GeraldWodni/bitkanoneV2/eda/doc/pcb_back.png

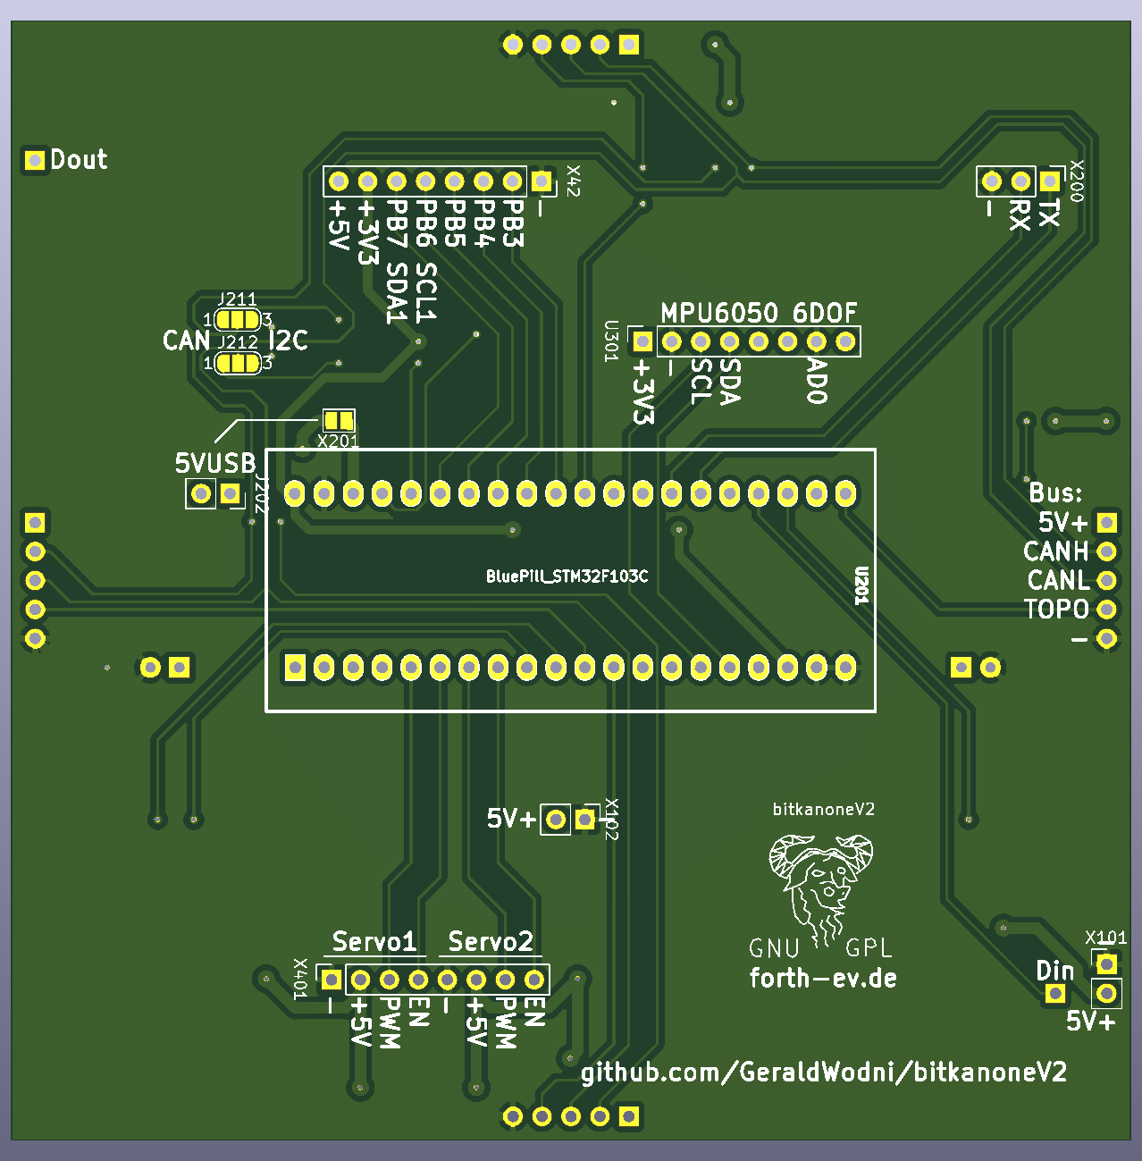
eda/doc/pcb_back.png
