GeraldWodni/bitkanoneV2/eda/doc/pcb_front.png

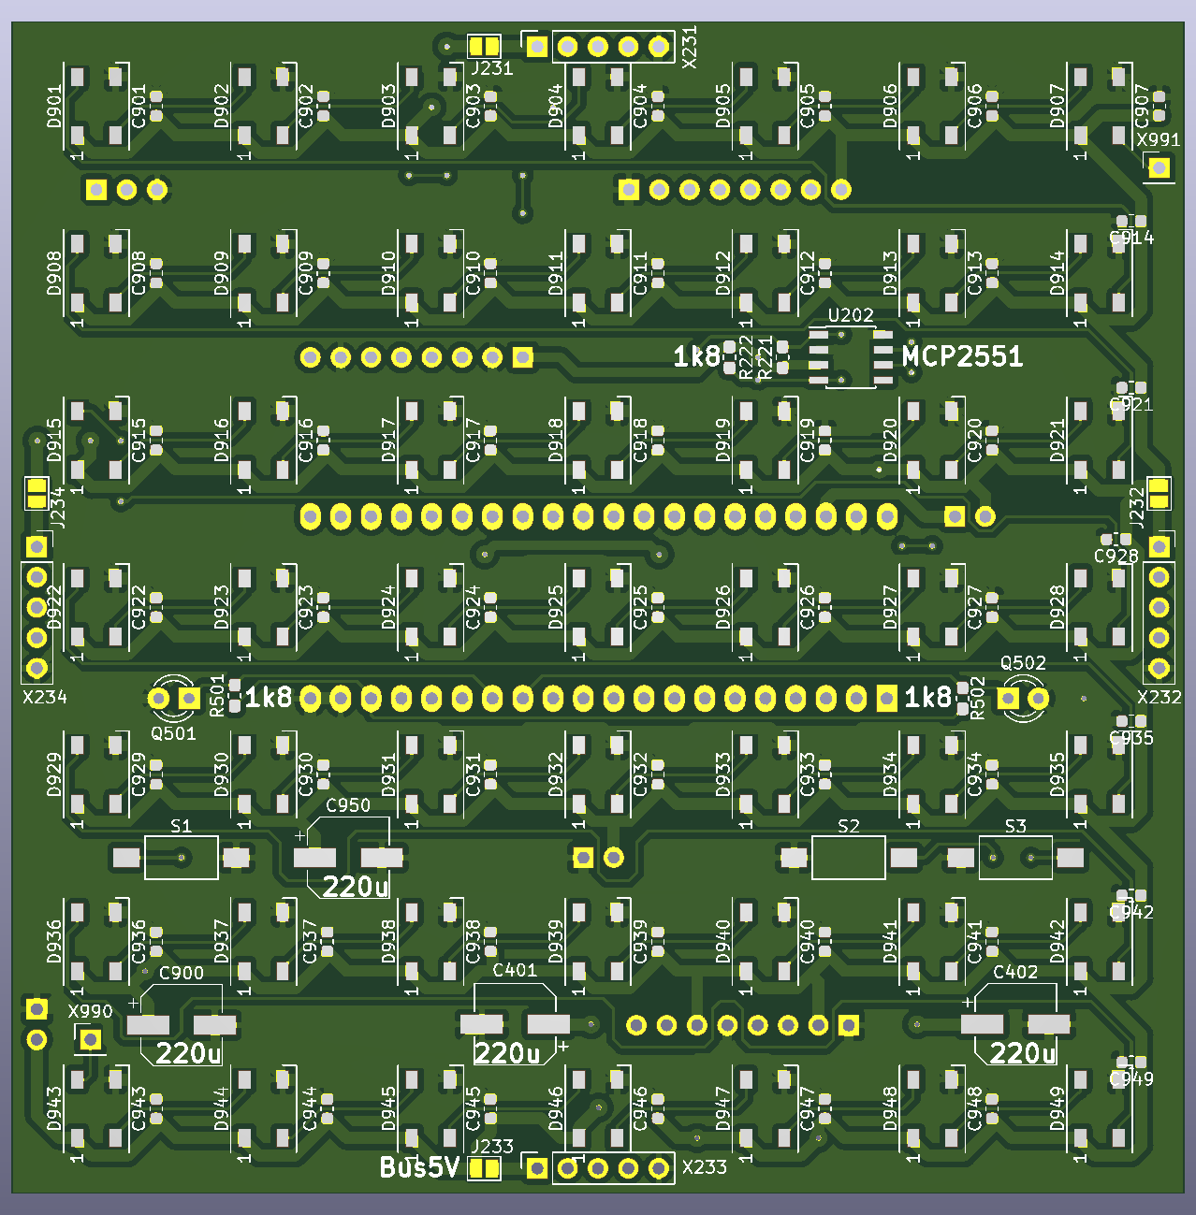
eda/doc/pcb_front.png
