GeraldWodni/bitkanoneV2/cad/Handheld.stl

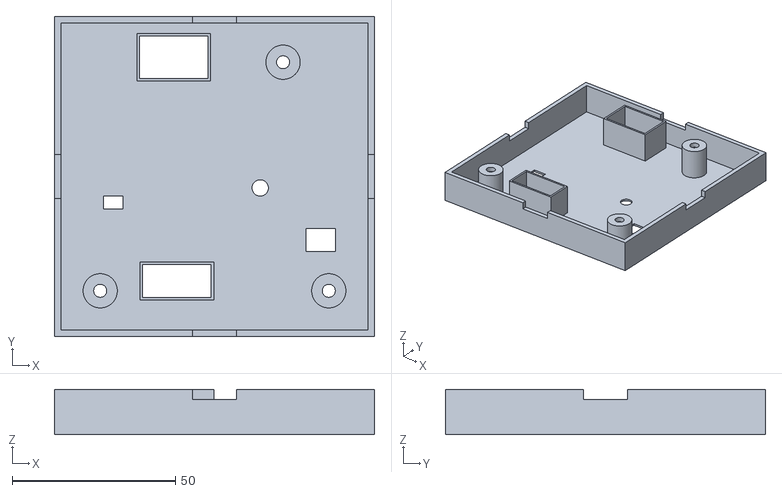
[picture p3: CAD file, 2019-04-07]
cad/Handheld.stl
98.0 x 98.0 x 13.8
