GeraldWodni/bitkanoneV2/cad/ResetButton.stl

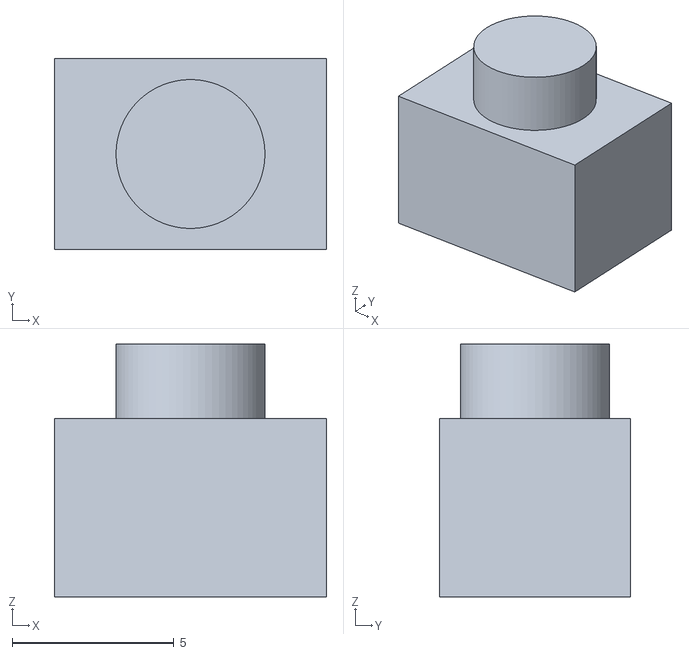
[picture p4: CAD file, 2019-04-07]
cad/ResetButton.stl
8.40 x 5.90 x 7.80
