GeraldWodni/bitkanoneV2/cad/Button.stl

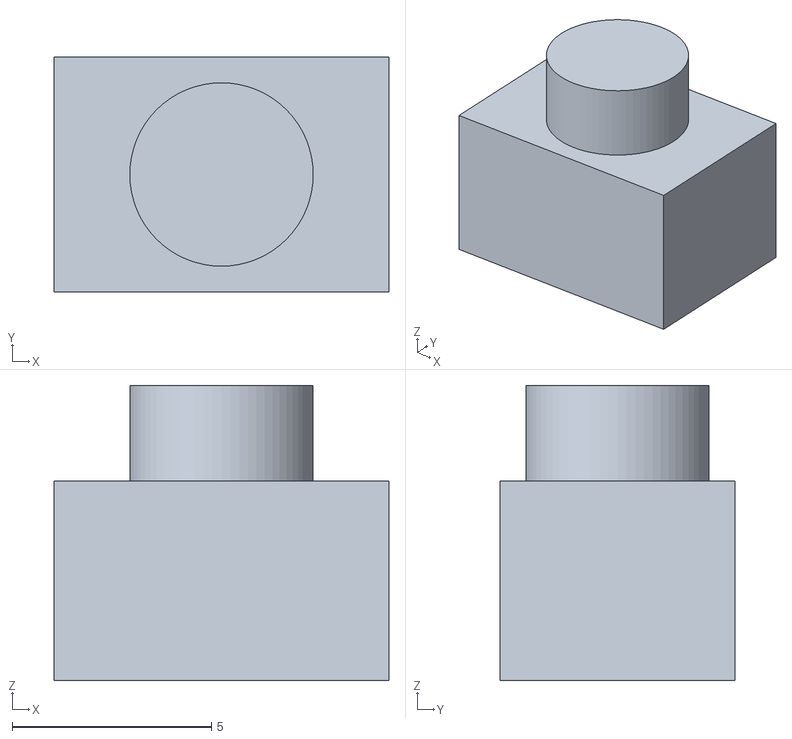
[picture p5: CAD file, 2019-04-07]
cad/Button.stl
8.40 x 5.90 x 7.40
