GeraldWodni/bitkanoneV2/cad/PanTiltMiddle.stl

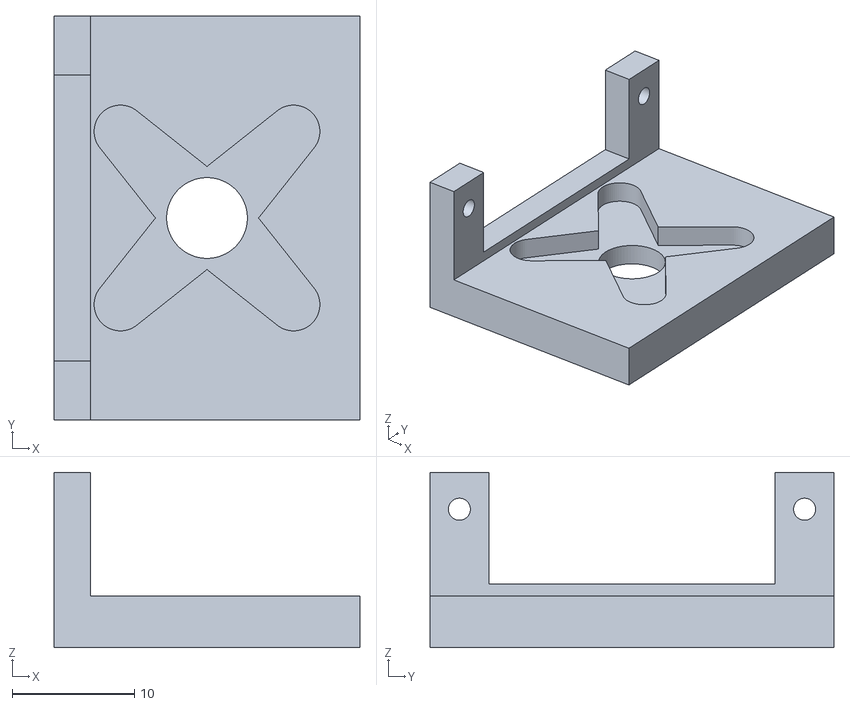
[picture p6: CAD file, 2018-12-27]
cad/PanTiltMiddle.stl
25.0 x 33.0 x 14.3
