GeraldWodni/bitkanoneV2/cad/PanTiltTop.stl

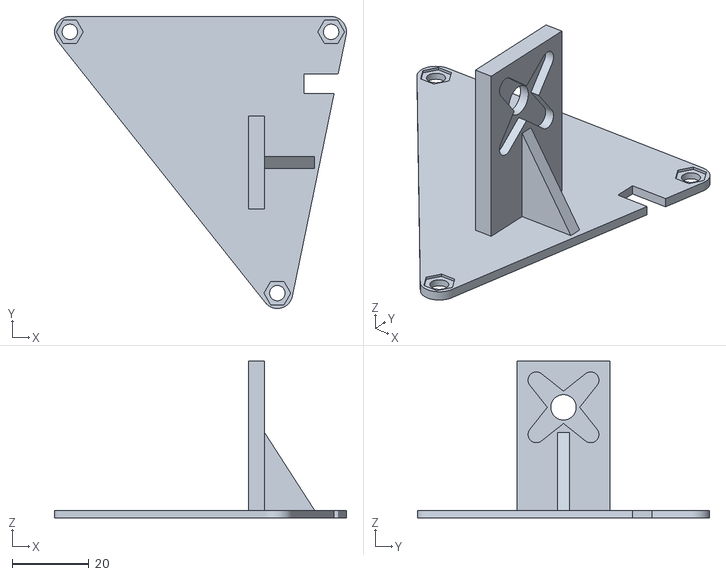
[picture p7: CAD file, 2018-12-27]
cad/PanTiltTop.stl
76.0 x 76.0 x 40.9
