GeraldWodni/bitkanoneV2/cad/PanTiltBottom.stl

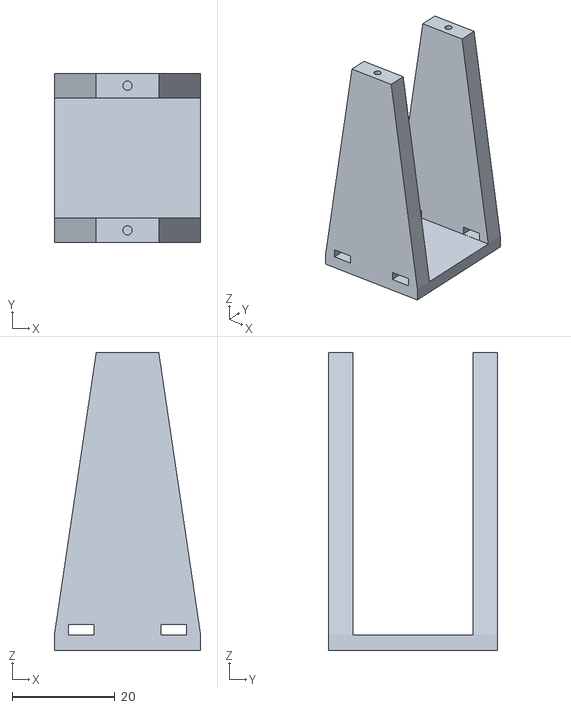
[picture p8: CAD file, 2018-12-27]
cad/PanTiltBottom.stl
28.5 x 33.0 x 58.1
