GeraldWodni/bitkanoneV2/cad/PanTiltSpacer.stl

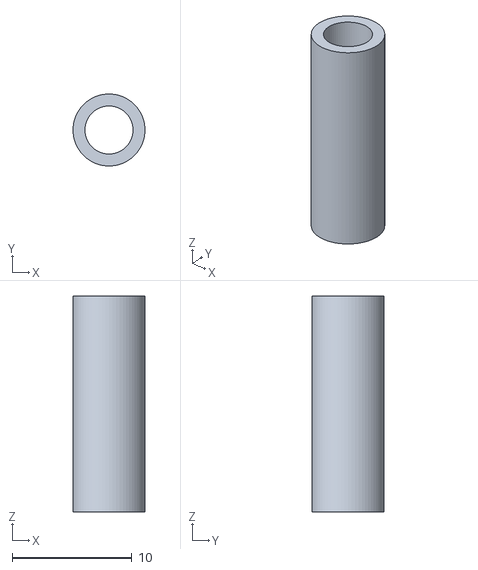
[picture p9: CAD file, 2018-12-27]
cad/PanTiltSpacer.stl
6.00 x 6.00 x 18.0
