GeraldWodni/bitkanoneV2/(threads)

Thread 3 (2019-01-03):

fonts does not work without USB driver

helmwo, 2019-01-03:
If you setup bitkanone without USB driver, it fails with fonts/fonts.fs.
C, is missing, this is defined inside standard.fs and usb-f1.txt.

So inside e4thcom.fs it's better to put the include for fonts/fonts.fs behind standard.fs.
The redefinition of C, should also be avoided. Maybe making standard.fs needed part for all sources.
