GeraldWodni/bitkanoneV2/eda/doc/BitkanoneV2-schematic.pdf

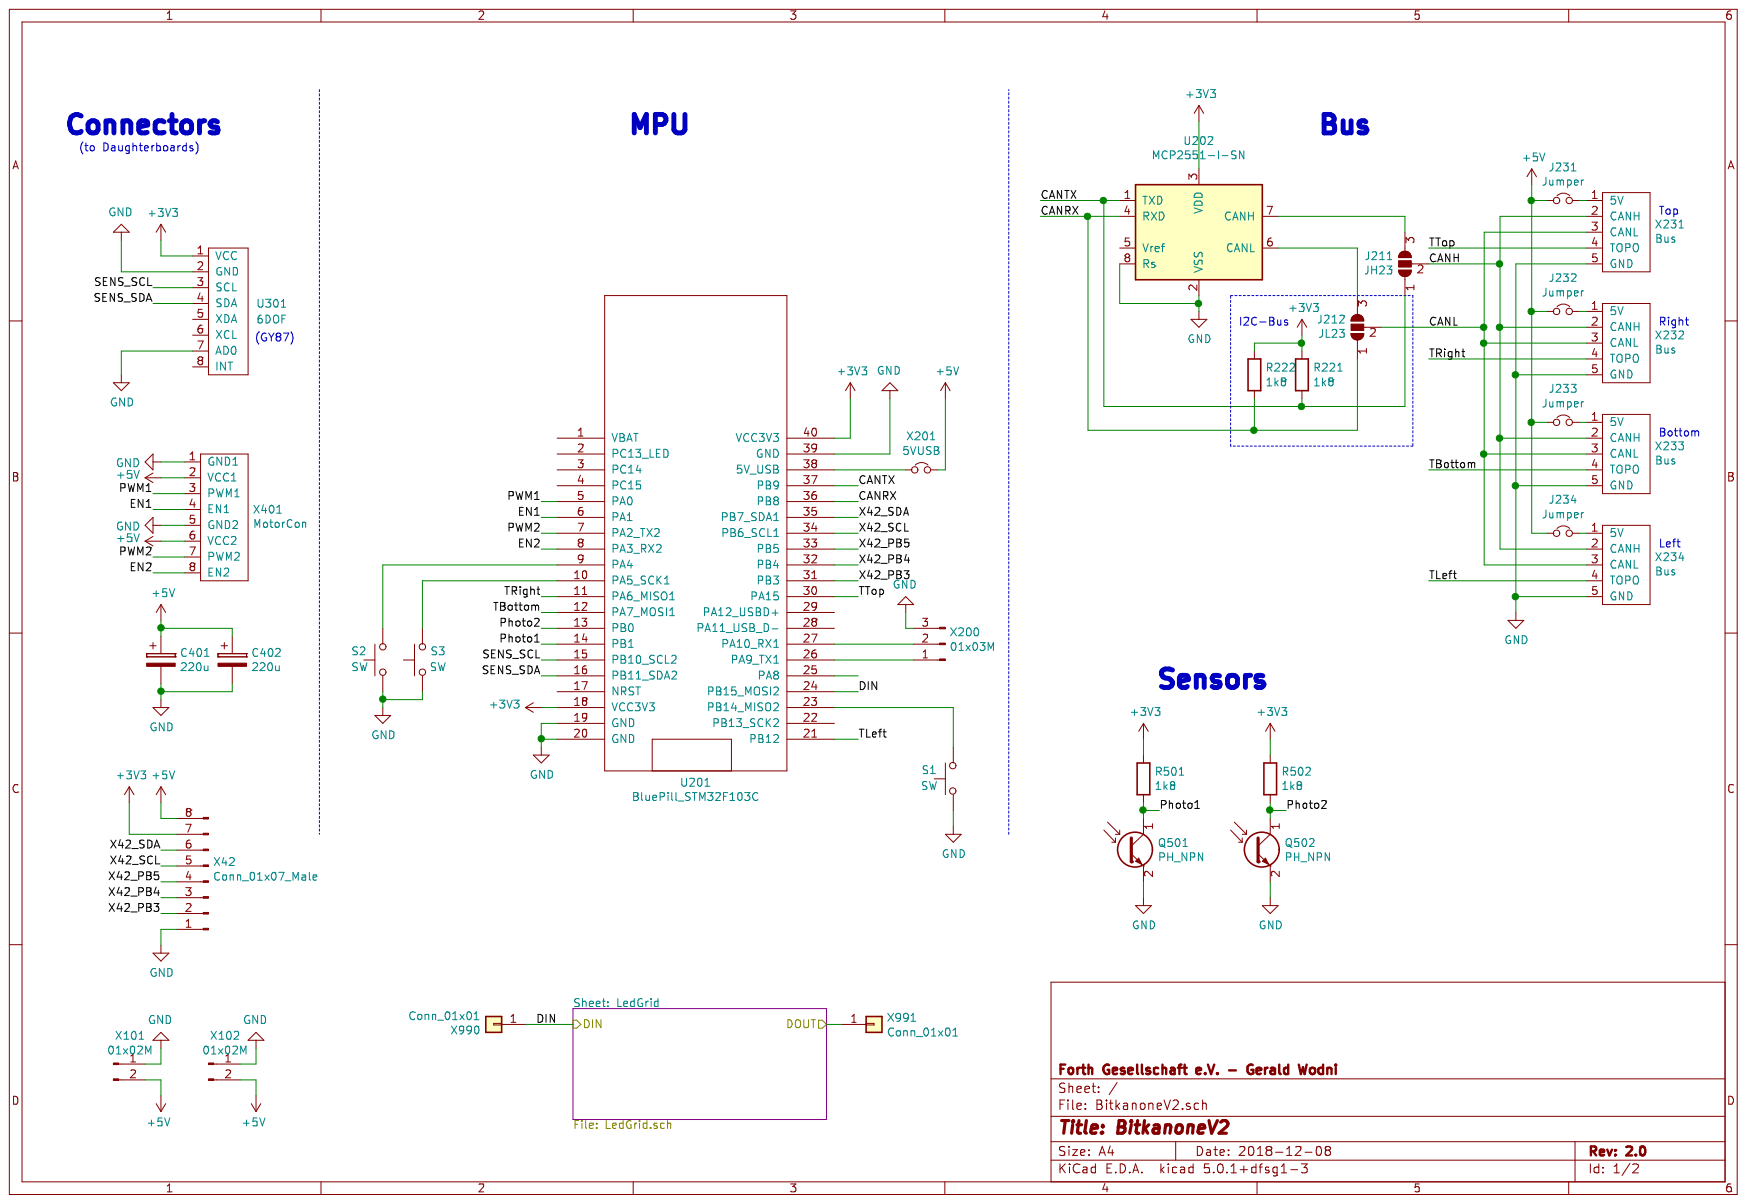
[picture p10: page 1]

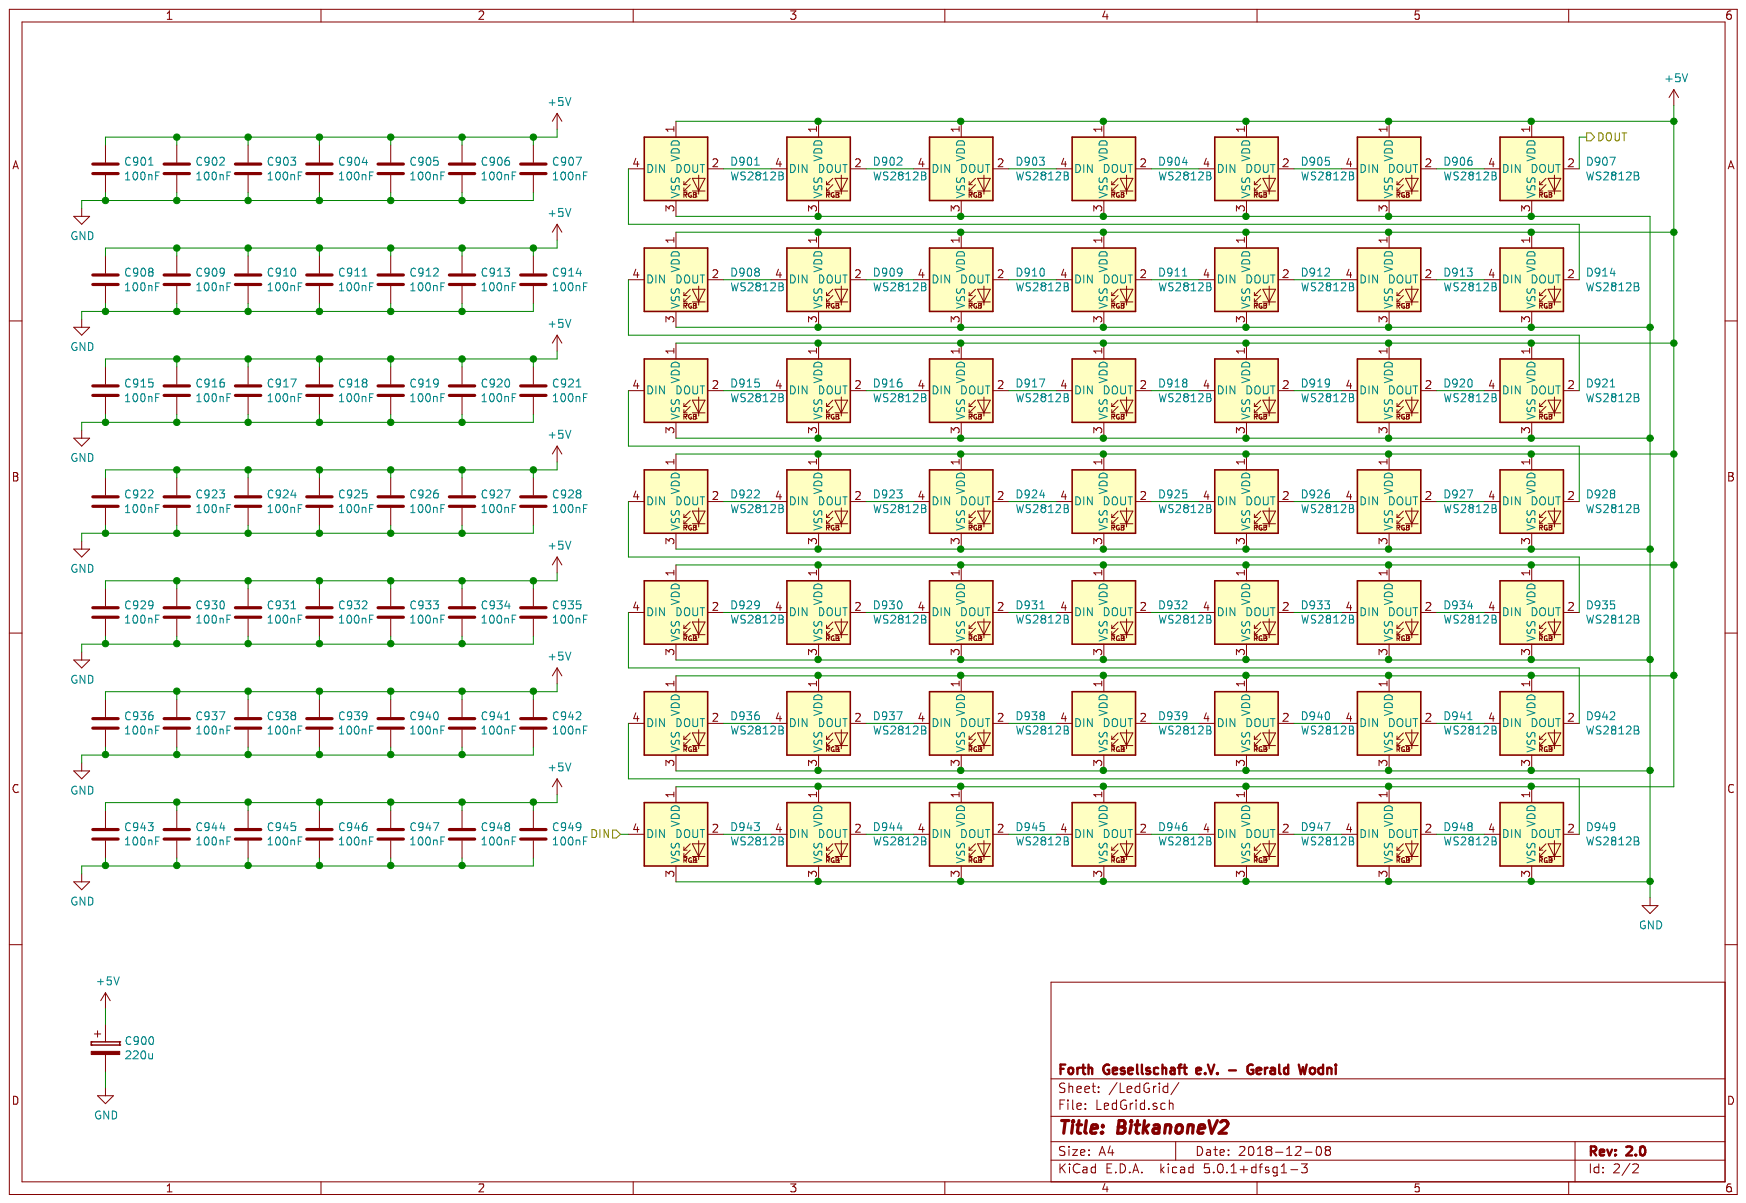
[picture p11: page 2]
