GeraldWodni/bitkanoneV2/eda/doc/BitkanoneV2-pcb.pdf

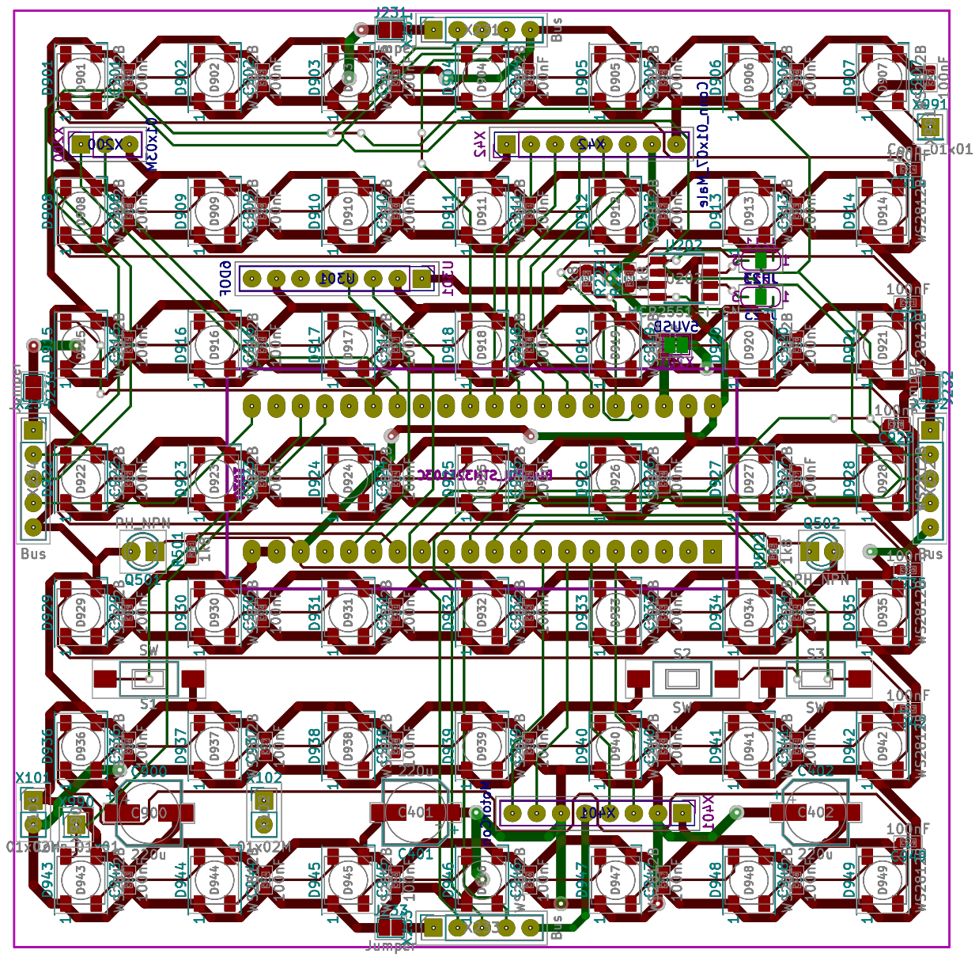
[picture p12: page 1]
