GeraldWodni/bitkanoneV2/eda/BitkanoneV2.kicad_pcb

## KiCad design eda/BitkanoneV2.kicad_pcb (2018-12-12)

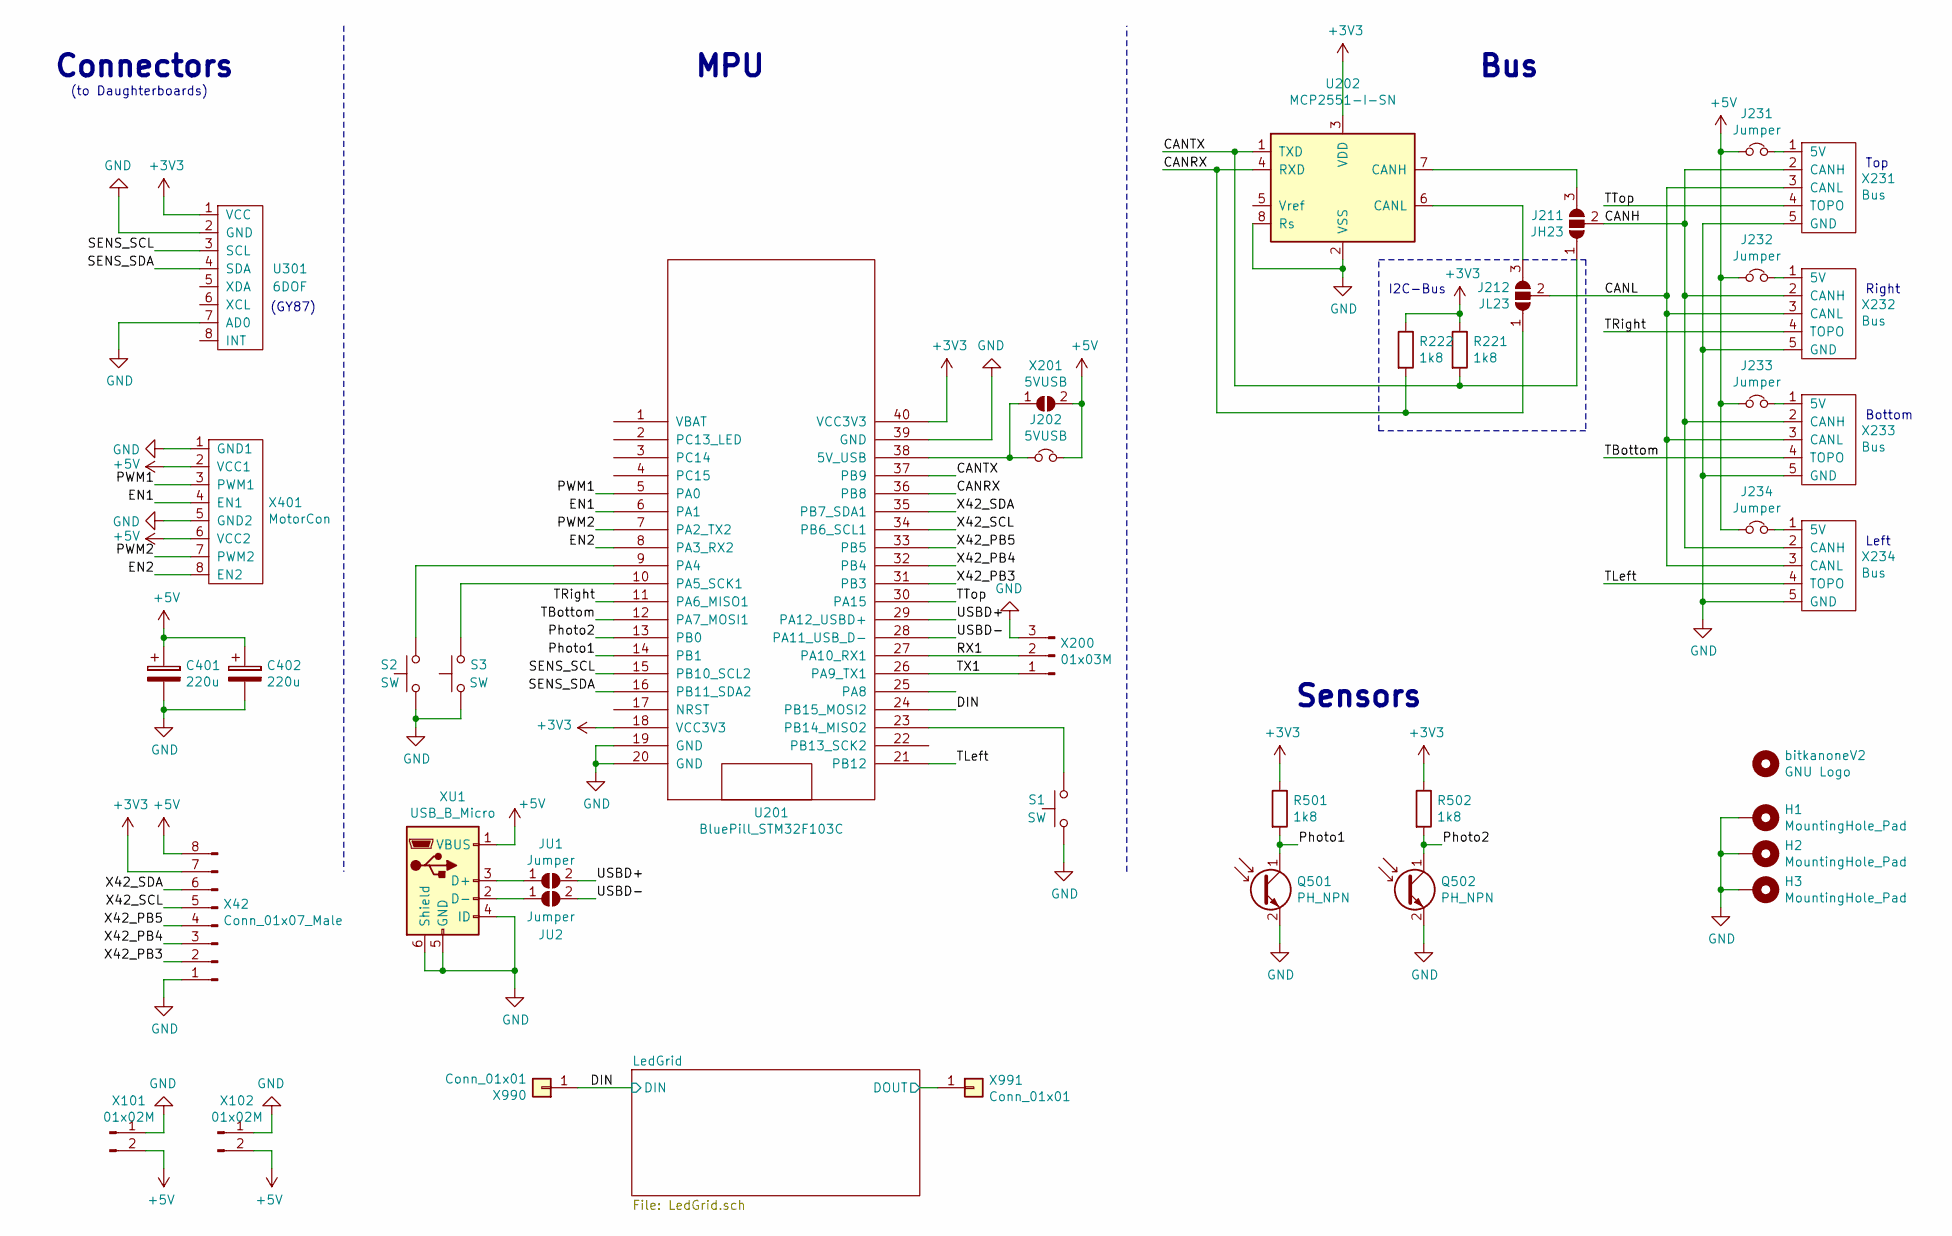
[picture p13: schematic BitkanoneV2.sch]

Parts:
C401, C402: 220u; CP_Elec_6.3x5.3
H1, H2, H3: MountingHole_Pad; MountingHole_3.2mm_M3_Pad_Via
J202: 5VUSB; PinSocket_1x02_P2.54mm_Vertical
J211: JH23; SolderJumper-3_P1.3mm_Open_RoundedPad1.0x1.5mm_NumberLabels
J212: JL23; SolderJumper-3_P1.3mm_Open_RoundedPad1.0x1.5mm_NumberLabels
J231, J232, J233, J234: Jumper; SolderJumper-2_P1.3mm_Open_Pad1.0x1.5mm
JU1, JU2: Jumper; SolderJumper-2_P1.3mm_Open_RoundedPad1.0x1.5mm
Q501, Q502: PH_NPN; LED_D3.0mm
R221, R222, R501, R502: 1k8; R_0603_1608Metric_Pad1.05x0.95mm_HandSolder
S1, S2, S3: SW; SW_SPST_FSMSM
U201: BluePill_STM32F103C; BluePill_STM32F103C_Center_NoPROG
U202: MCP2551-I-SN; SOIC-8_3.9x4.9mm_P1.27mm
U301: 6DOF; PinSocket_1x08_P2.54mm_Vertical
X42: Conn_01x07_Male; PinSocket_1x08_P2.54mm_Vertical
X101, X102: 01x02M; PinHeader_1x02_P2.54mm_Vertical
X200: 01x03M; PinHeader_1x03_P2.54mm_Vertical
X201: 5VUSB; SolderJumper-2_P1.3mm_Open_Pad1.0x1.5mm
X231, X232, X233, X234: Bus; PinSocket_1x05_P2.54mm_Vertical
X401: MotorCon; PinSocket_1x08_P2.54mm_Vertical
X990, X991: Conn_01x01; PinHeader_1x01_P2.54mm_Vertical
XU1: USB_B_Micro; USB_Micro-B_Molex-105017-0001
bitkanoneV2: GNU Logo; Symbol_GNU-Logo_SilkscreenTop

Connections:
+3V3: R221.1, R222.1, R501.1, R502.1, U201.18 (VCC3V3), U201.40 (VCC3V3), U202.3 (VDD), U301.1 (VCC), X42.7
+5V: C401.1, C402.1, J202.2, J231.1, J232.1, J233.1, J234.1, X42.8, X101.2, X102.2, X201.2 (B), X401.2 (VCC1), X401.6 (VCC2), XU1.1 (VBUS); also elsewhere on the board
/CANH: J211.2 (C), X231.2 (CANH), X232.2 (CANH), X233.2 (CANH), X234.2 (CANH)
/CANL: J212.2 (C), X231.3 (CANL), X232.3 (CANL), X233.3 (CANL), X234.3 (CANL)
/CANRX: J212.1 (A), R222.2, U201.36 (PB8), U202.4 (RXD)
/CANTX: J211.1 (A), R221.2, U201.37 (PB9), U202.1 (TXD)
/DIN: U201.24 (PB15_MOSI2), X990.1; also elsewhere on the board
/EN1: U201.6 (PA1), X401.4 (EN1)
/EN2: U201.8 (PA3_RX2), X401.8 (EN2)
/LedGrid/DOUT: X991.1; also elsewhere on the board
/PWM1: U201.5 (PA0), X401.3 (PWM1)
/PWM2: U201.7 (PA2_TX2), X401.7 (PWM2)
/Photo1: Q501.1 (C), R501.2, U201.14 (PB1)
/Photo2: Q502.1 (C), R502.2, U201.13 (PB0)
/RX1: U201.27 (PA10_RX1), X200.2
/SENS_SCL: U201.15 (PB10_SCL2), U301.3 (SCL)
/SENS_SDA: U201.16 (PB11_SDA2), U301.4 (SDA)
/TBottom: U201.12 (PA7_MOSI1), X233.4 (TOPO)
/TLeft: U201.21 (PB12), X234.4 (TOPO)
/TRight: U201.11 (PA6_MISO1), X232.4 (TOPO)
/TTop: U201.30 (PA15), X231.4 (TOPO)
/TX1: U201.26 (PA9_TX1), X200.1
/USBD+: JU1.2 (B), U201.29 (PA12_USBD+)
/USBD-: JU2.2 (B), U201.28 (PA11_USB_D-)
/X42_PB3: U201.31 (PB3), X42.2
/X42_PB4: U201.32 (PB4), X42.3
/X42_PB5: U201.33 (PB5), X42.4
/X42_SCL: U201.34 (PB6_SCL1), X42.5
/X42_SDA: U201.35 (PB7_SDA1), X42.6
GND: C401.2, C402.2, H1.1, H2.1, H3.1, Q501.2 (E), Q502.2 (E), S1.1, S2.1, S3.1, U201.19 (GND), U201.20 (GND), U201.39 (GND), U202.2 (VSS), U202.8 (Rs), U301.2 (GND), U301.7 (AD0), X42.1, X101.1, X102.1, X200.3, X231.5 (GND), X232.5 (GND), X233.5 (GND), X234.5 (GND), X401.1 (GND1), X401.5 (GND2), XU1.4 (ID), XU1.5 (GND), XU1.6 (Shield); also elsewhere on the board
unnamed: J202.1, U201.38 (5V_USB), X201.1 (A)
unnamed: J211.3 (B), U202.7 (CANH)
unnamed: J212.3 (B), U202.6 (CANL)
unnamed: J231.2, X231.1 (5V)
unnamed: J232.2, X232.1 (5V)
unnamed: J233.2, X233.1 (5V)
unnamed: J234.2, X234.1 (5V)
unnamed: JU1.1 (A), XU1.3 (D+)
unnamed: JU2.1 (A), XU1.2 (D-)
unnamed: S1.2, U201.23 (PB14_MISO2)
unnamed: S2.2, U201.9 (PA4)
unnamed: S3.2, U201.10 (PA5_SCK1)

Notes on the sheet:
I2C-Bus
Bus
MPU
Connectors
(to Daughterboards)
(GY87)
Left
Bottom
Right
Top
Sensors

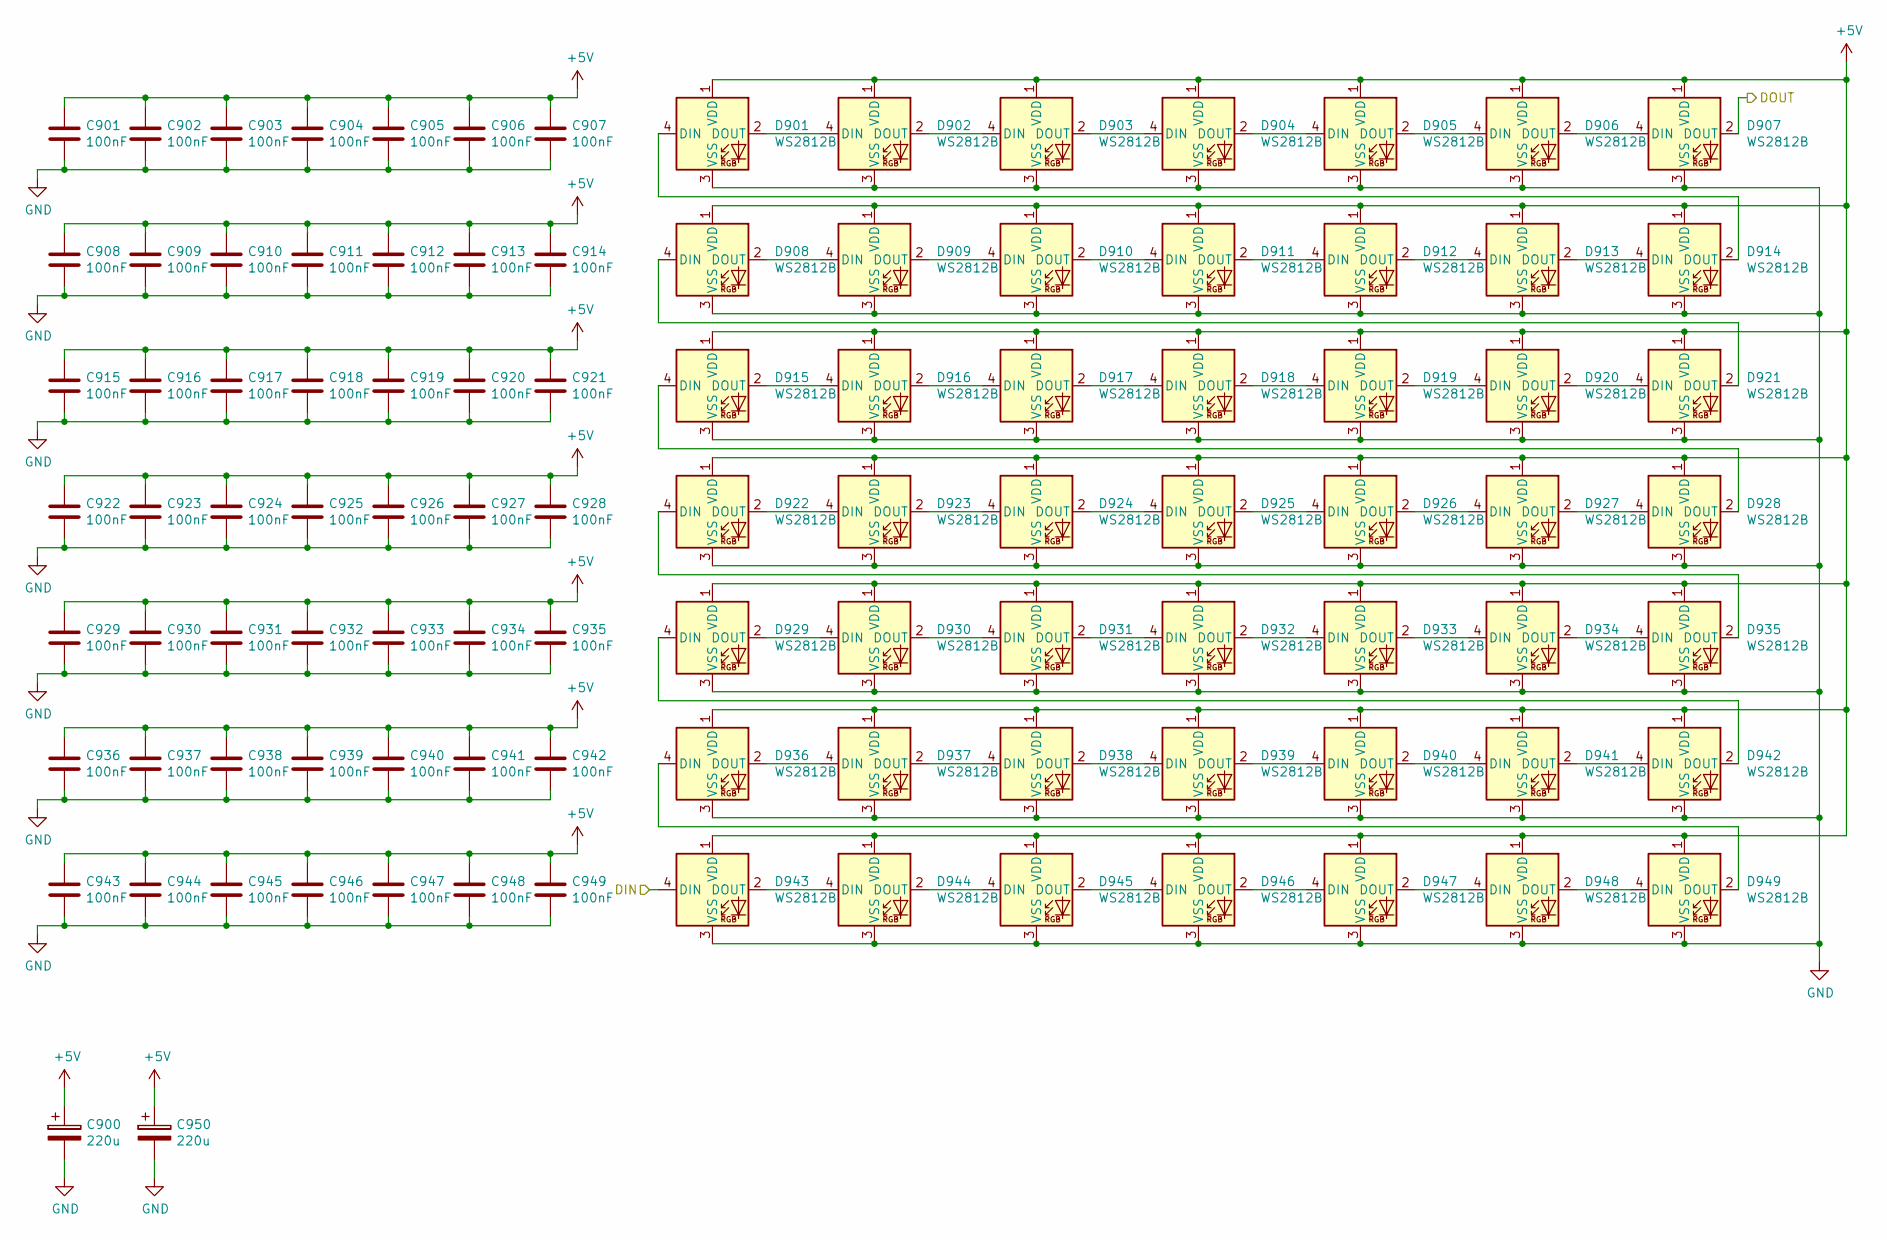
[picture p14: schematic LedGrid.sch, BitkanoneV2]

Parts:
C900, C950: 220u; CP_Elec_6.3x5.3
C901, C902, C903, C904, C905, C906, C907, C908, C909, C910, C911, C912, C913, C914, C915, C916, C917, C918, C919, C920, C921, C922, C923, C924, C925, C926, C927, C928, C929, C930, C931, C932, C933, C934, C935, C936, C937, C938, C939, C940, C941, C942, C943, C944, C945, C946, C947, C948, C949: 100nF; C_0603_1608Metric
D901, D902, D903, D904, D905, D906, D907, D908, D909, D910, D911, D912, D913, D914, D915, D916, D917, D918, D919, D920, D921, D922, D923, D924, D925, D926, D927, D928, D929, D930, D931, D932, D933, D934, D935, D936, D937, D938, D939, D940, D941, D942, D943, D944, D945, D946, D947, D948, D949: WS2812B; LED_WS2812B_PLCC4_5.0x5.0mm_P3.2mm

Connections:
+5V: C900.1, C901.1, C902.1, C903.1, C904.1, C905.1, C906.1, C907.1, C908.1, C909.1, C910.1, C911.1, C912.1, C913.1, C914.1, C915.1, C916.1, C917.1, C918.1, C919.1, C920.1, C921.1, C922.1, C923.1, C924.1, C925.1, C926.1, C927.1, C928.1, C929.1, C930.1, C931.1, C932.1, C933.1, C934.1, C935.1, C936.1, C937.1, C938.1, C939.1, C940.1, C941.1, C942.1, C943.1, C944.1, C945.1, C946.1, C947.1, C948.1, C949.1, C950.1, D901.1 (VDD), D902.1 (VDD), D903.1 (VDD), D904.1 (VDD), D905.1 (VDD), D906.1 (VDD), D907.1 (VDD), D908.1 (VDD), D909.1 (VDD), D910.1 (VDD), D911.1 (VDD), D912.1 (VDD), D913.1 (VDD), D914.1 (VDD), D915.1 (VDD), D916.1 (VDD), D917.1 (VDD), D918.1 (VDD), D919.1 (VDD), D920.1 (VDD), D921.1 (VDD), D922.1 (VDD), D923.1 (VDD), D924.1 (VDD), D925.1 (VDD), D926.1 (VDD), D927.1 (VDD), D928.1 (VDD), D929.1 (VDD), D930.1 (VDD), D931.1 (VDD), D932.1 (VDD), D933.1 (VDD), D934.1 (VDD), D935.1 (VDD), D936.1 (VDD), D937.1 (VDD), D938.1 (VDD), D939.1 (VDD), D940.1 (VDD), D941.1 (VDD), D942.1 (VDD), D943.1 (VDD), D944.1 (VDD), D945.1 (VDD), D946.1 (VDD), D947.1 (VDD), D948.1 (VDD), D949.1 (VDD); also elsewhere on the board
/DIN: D943.4 (DIN); also elsewhere on the board
/LedGrid/DOUT: D907.2 (DOUT); also elsewhere on the board
GND: C900.2, C901.2, C902.2, C903.2, C904.2, C905.2, C906.2, C907.2, C908.2, C909.2, C910.2, C911.2, C912.2, C913.2, C914.2, C915.2, C916.2, C917.2, C918.2, C919.2, C920.2, C921.2, C922.2, C923.2, C924.2, C925.2, C926.2, C927.2, C928.2, C929.2, C930.2, C931.2, C932.2, C933.2, C934.2, C935.2, C936.2, C937.2, C938.2, C939.2, C940.2, C941.2, C942.2, C943.2, C944.2, C945.2, C946.2, C947.2, C948.2, C949.2, C950.2, D901.3 (VSS), D902.3 (VSS), D903.3 (VSS), D904.3 (VSS), D905.3 (VSS), D906.3 (VSS), D907.3 (VSS), D908.3 (VSS), D909.3 (VSS), D910.3 (VSS), D911.3 (VSS), D912.3 (VSS), D913.3 (VSS), D914.3 (VSS), D915.3 (VSS), D916.3 (VSS), D917.3 (VSS), D918.3 (VSS), D919.3 (VSS), D920.3 (VSS), D921.3 (VSS), D922.3 (VSS), D923.3 (VSS), D924.3 (VSS), D925.3 (VSS), D926.3 (VSS), D927.3 (VSS), D928.3 (VSS), D929.3 (VSS), D930.3 (VSS), D931.3 (VSS), D932.3 (VSS), D933.3 (VSS), D934.3 (VSS), D935.3 (VSS), D936.3 (VSS), D937.3 (VSS), D938.3 (VSS), D939.3 (VSS), D940.3 (VSS), D941.3 (VSS), D942.3 (VSS), D943.3 (VSS), D944.3 (VSS), D945.3 (VSS), D946.3 (VSS), D947.3 (VSS), D948.3 (VSS), D949.3 (VSS); also elsewhere on the board
unnamed: D901.2 (DOUT), D902.4 (DIN)
unnamed: D901.4 (DIN), D914.2 (DOUT)
unnamed: D902.2 (DOUT), D903.4 (DIN)
unnamed: D903.2 (DOUT), D904.4 (DIN)
unnamed: D904.2 (DOUT), D905.4 (DIN)
unnamed: D905.2 (DOUT), D906.4 (DIN)
unnamed: D906.2 (DOUT), D907.4 (DIN)
unnamed: D908.2 (DOUT), D909.4 (DIN)
unnamed: D908.4 (DIN), D921.2 (DOUT)
unnamed: D909.2 (DOUT), D910.4 (DIN)
unnamed: D910.2 (DOUT), D911.4 (DIN)
unnamed: D911.2 (DOUT), D912.4 (DIN)
unnamed: D912.2 (DOUT), D913.4 (DIN)
unnamed: D913.2 (DOUT), D914.4 (DIN)
unnamed: D915.2 (DOUT), D916.4 (DIN)
unnamed: D915.4 (DIN), D928.2 (DOUT)
unnamed: D916.2 (DOUT), D917.4 (DIN)
unnamed: D917.2 (DOUT), D918.4 (DIN)
unnamed: D918.2 (DOUT), D919.4 (DIN)
unnamed: D919.2 (DOUT), D920.4 (DIN)
unnamed: D920.2 (DOUT), D921.4 (DIN)
unnamed: D922.2 (DOUT), D923.4 (DIN)
unnamed: D922.4 (DIN), D935.2 (DOUT)
unnamed: D923.2 (DOUT), D924.4 (DIN)
unnamed: D924.2 (DOUT), D925.4 (DIN)
unnamed: D925.2 (DOUT), D926.4 (DIN)
unnamed: D926.2 (DOUT), D927.4 (DIN)
unnamed: D927.2 (DOUT), D928.4 (DIN)
unnamed: D929.2 (DOUT), D930.4 (DIN)
unnamed: D929.4 (DIN), D942.2 (DOUT)
unnamed: D930.2 (DOUT), D931.4 (DIN)
unnamed: D931.2 (DOUT), D932.4 (DIN)
unnamed: D932.2 (DOUT), D933.4 (DIN)
unnamed: D933.2 (DOUT), D934.4 (DIN)
unnamed: D934.2 (DOUT), D935.4 (DIN)
unnamed: D936.2 (DOUT), D937.4 (DIN)
unnamed: D936.4 (DIN), D949.2 (DOUT)
unnamed: D937.2 (DOUT), D938.4 (DIN)
unnamed: D938.2 (DOUT), D939.4 (DIN)
unnamed: D939.2 (DOUT), D940.4 (DIN)
unnamed: D940.2 (DOUT), D941.4 (DIN)
unnamed: D941.2 (DOUT), D942.4 (DIN)
unnamed: D943.2 (DOUT), D944.4 (DIN)
unnamed: D944.2 (DOUT), D945.4 (DIN)
unnamed: D945.2 (DOUT), D946.4 (DIN)
unnamed: D946.2 (DOUT), D947.4 (DIN)
unnamed: D947.2 (DOUT), D948.4 (DIN)
unnamed: D948.2 (DOUT), D949.4 (DIN)

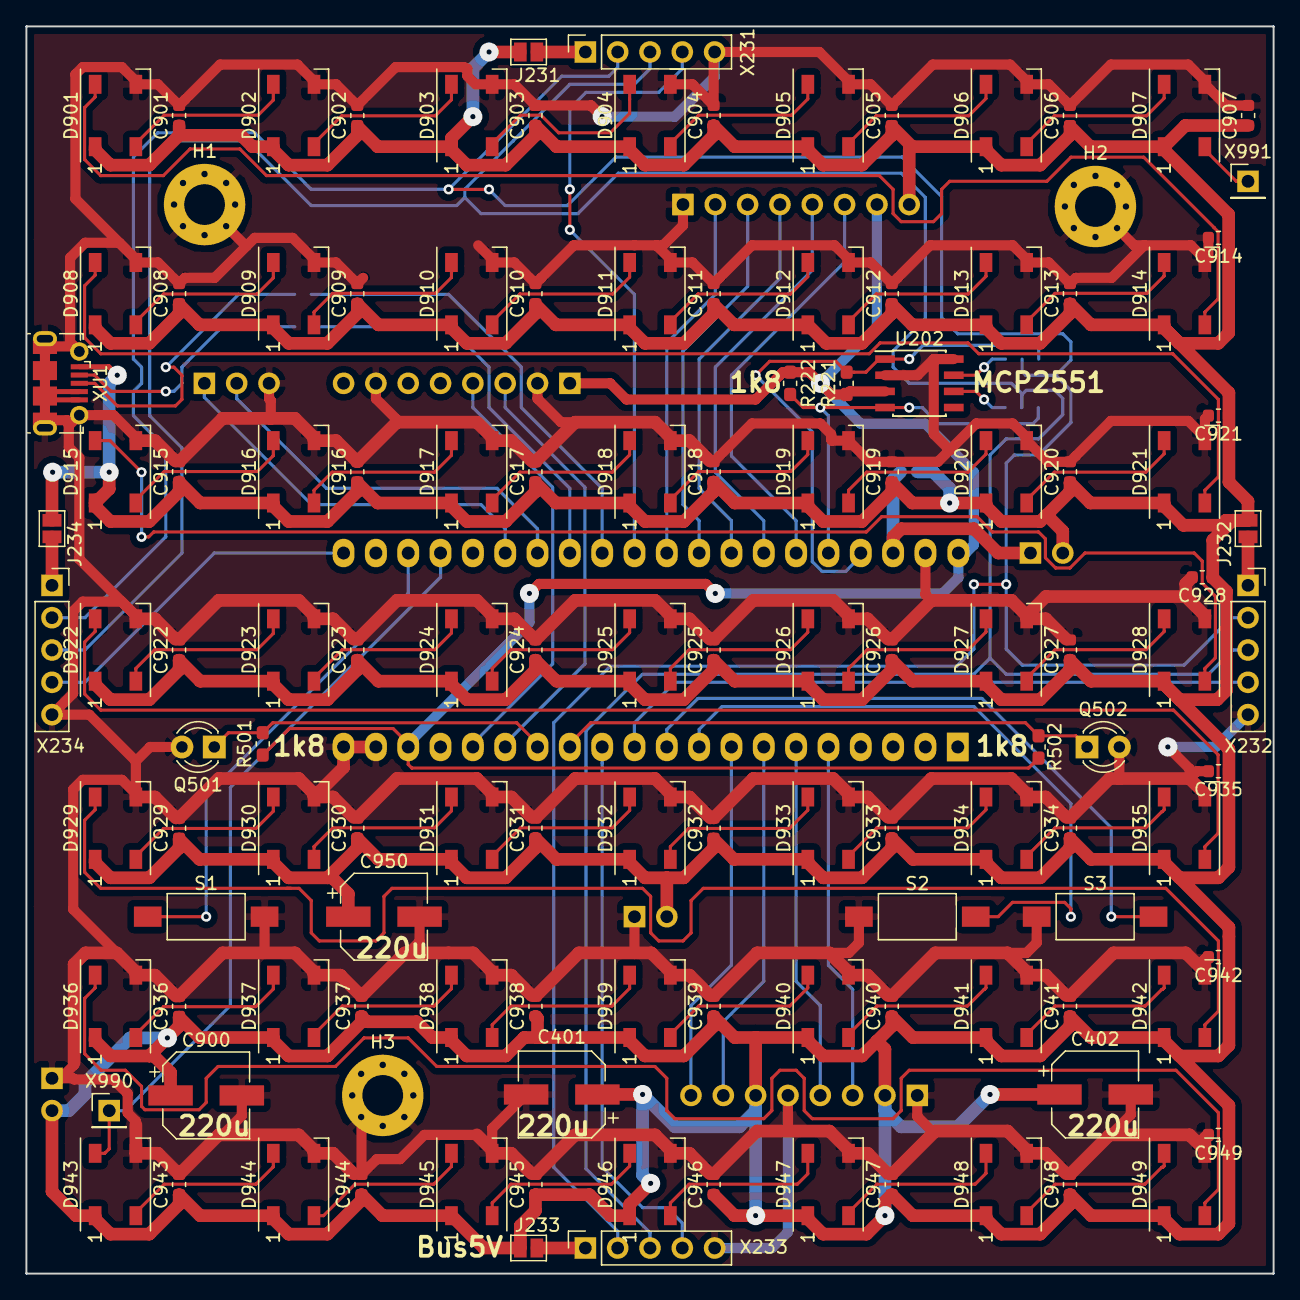
[picture p15: board BitkanoneV2.kicad_pcb from above]

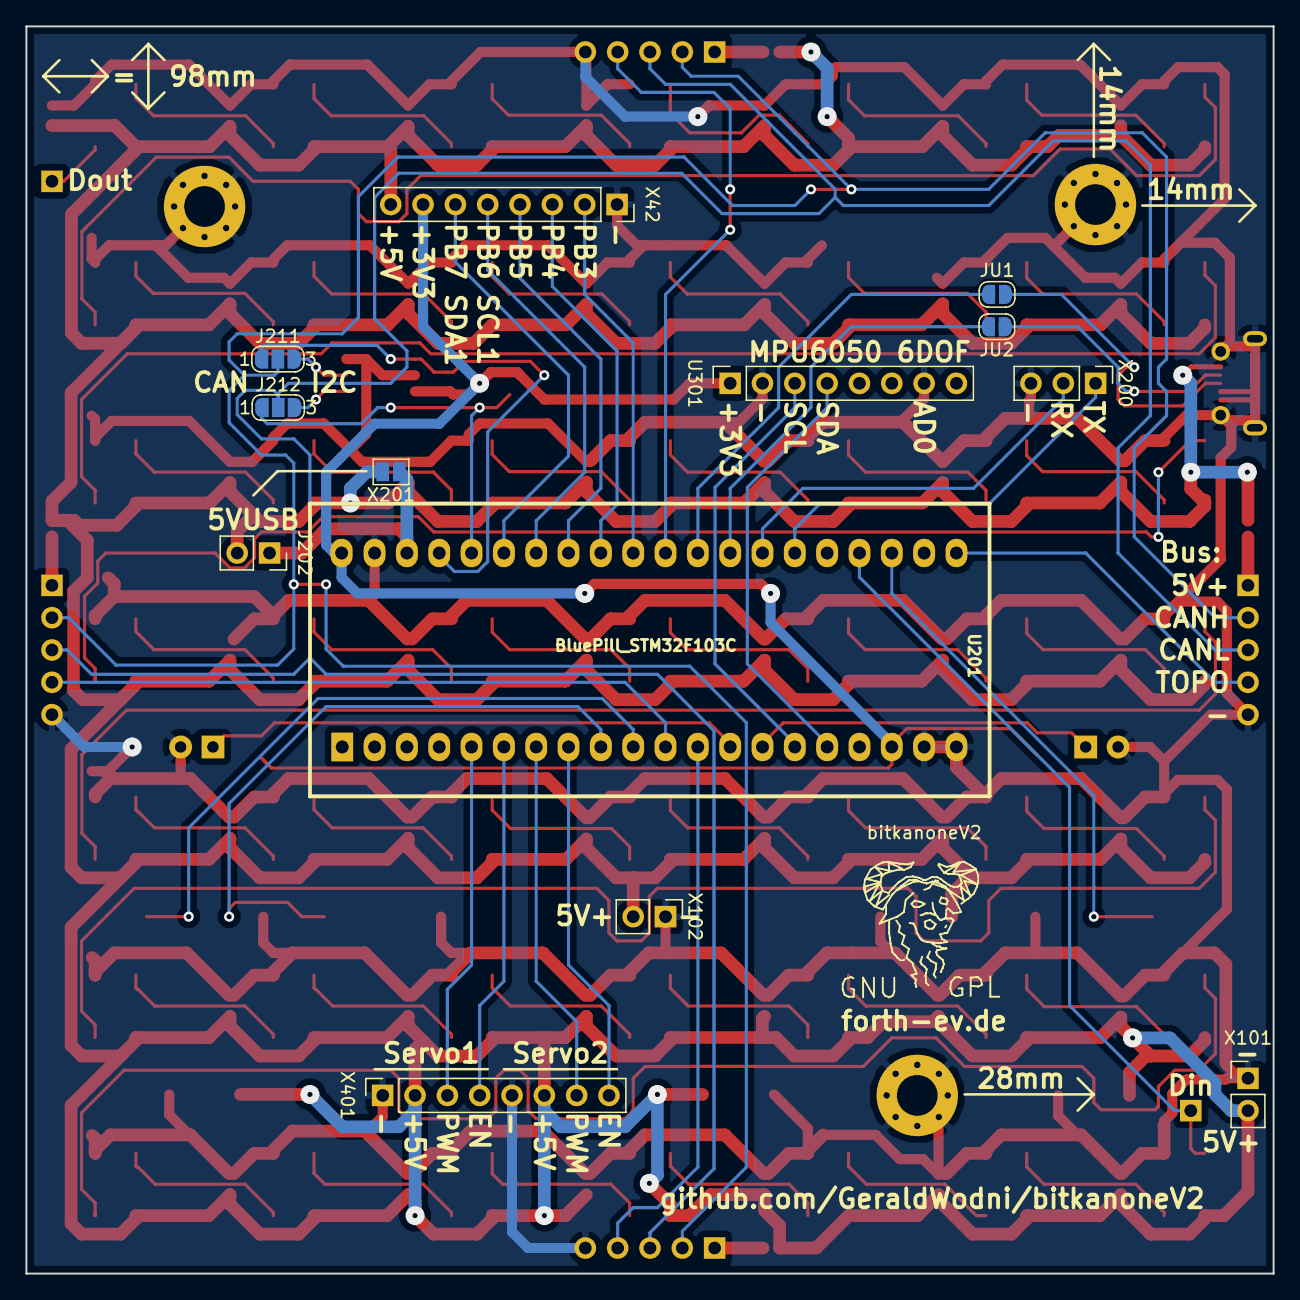
[picture p16: board BitkanoneV2.kicad_pcb from below]

Board: 2 copper layers, 98.0 x 98.0 mm, 140 parts (14 on the bottom side), 90 nets.
