GeraldWodni/bitkanoneV2/(commit log)

2018-12-08 Schematic done, needs hierarchy
    [BitkanoneV2.kicad_pcb, BitkanoneV2.sch, LedGrid.sch]
2018-12-08 WS2812B grid finished
    [BitkanoneV2.kicad_pcb, BitkanoneV2.sch, LedGrid.sch]
2018-12-09 placement finished
    [BitkanoneV2.kicad_pcb, BitkanoneV2.sch, LedGrid.sch]
2018-12-09 all but bus routed
    [BitkanoneV2.kicad_pcb, BitkanoneV2.sch]
2018-12-10 routing finished
    [BitkanoneV2.kicad_pcb, BitkanoneV2.sch]
2018-12-10 Pdf printouts added
2018-12-11 U301:more space; Phototransistors, Buttons and X42 added
    [BitkanoneV2.kicad_pcb, BitkanoneV2.sch]
2018-12-11 silk screen documentation added
    [BitkanoneV2.kicad_pcb, BitkanoneV2.sch, LedGrid.sch]
2018-12-11 Software started, GPIO led can now turn on and off, yay :D
2018-12-12 spi output working
2018-12-12 USB port added; Mounting holes added; Silk screen measurements added
    [BitkanoneV2.kicad_pcb, BitkanoneV2.sch]
2018-12-12 bitkanoneV2 first PCB run ordered
    [BitkanoneV2-B.Cu.gbr, BitkanoneV2-B.Mask.gbr, BitkanoneV2-B.Paste.gbr, BitkanoneV2-B.SilkS.gbr, BitkanoneV2-Edge.Cuts.gbr, BitkanoneV2-F.Cu.gbr, BitkanoneV2-F.Mask.gbr, BitkanoneV2-F.Paste.gbr]
2018-12-22 gpio: buttons added; gpio-configure fixed (multiple assignments); led matrix on pcb working
2018-12-22 I2C scanning works
2018-12-23 software i2c working
2018-12-23 cad: PanTilt started
    [PanTilt.scad, Screw.scad]
2018-12-23 i2c-sw: write working
2018-12-23 pwm working
2018-12-23 only PWM1+2 see to be working, broken attempt
2018-12-24 pwm working on both channels
2018-12-24 pwm integrated in init chain
2018-12-24 pwms (servos) added to test program
2018-12-25 cad: servoArm & servoCross started
    [PanTilt.scad]
2018-12-26 USB tty driver added from Jean-Claude Wippler
2018-12-27 cad PanTilt printed: top+middle working, bottom still printing
    [PanTilt.scad, PanTiltBottom.stl, PanTiltMiddle.stl, PanTiltSpacer.stl, PanTiltTop.stl]
2018-12-27 double bottom for easy printing added
2018-12-28 Ledcom added to topo pins
    [BitkanoneV2.sch]
2018-12-28 schematic: ledcom cathode fixed
    [BitkanoneV2.sch]
2018-12-29 hsv>rgb added; scanner switches hue (super slow)
2018-12-31 led-nt defered: allows for bis-store
2019-01-05 mpu skip added (S3), ledcheck app added
2019-01-06 apps: preliminary logos added, logo switching working
2019-01-08 bresenham cleaned up
    [Bresenham.ods]
2019-04-06 cad: Diffusor added
    [Diffusor.scad]
2019-04-07 Button added (to Diffusor.scad)
    [Button.stl, Diffusor.scad]
2019-04-07 cad: Handheld added
    [Handheld.scad, Handheld.stl]
2019-04-07 cad: ResetButton added to handheld
    [Handheld.scad, Handheld.stl, ResetButton.stl]
